Mario19831983/Volvo-DPF-indik-tor/04_bastl.jpg

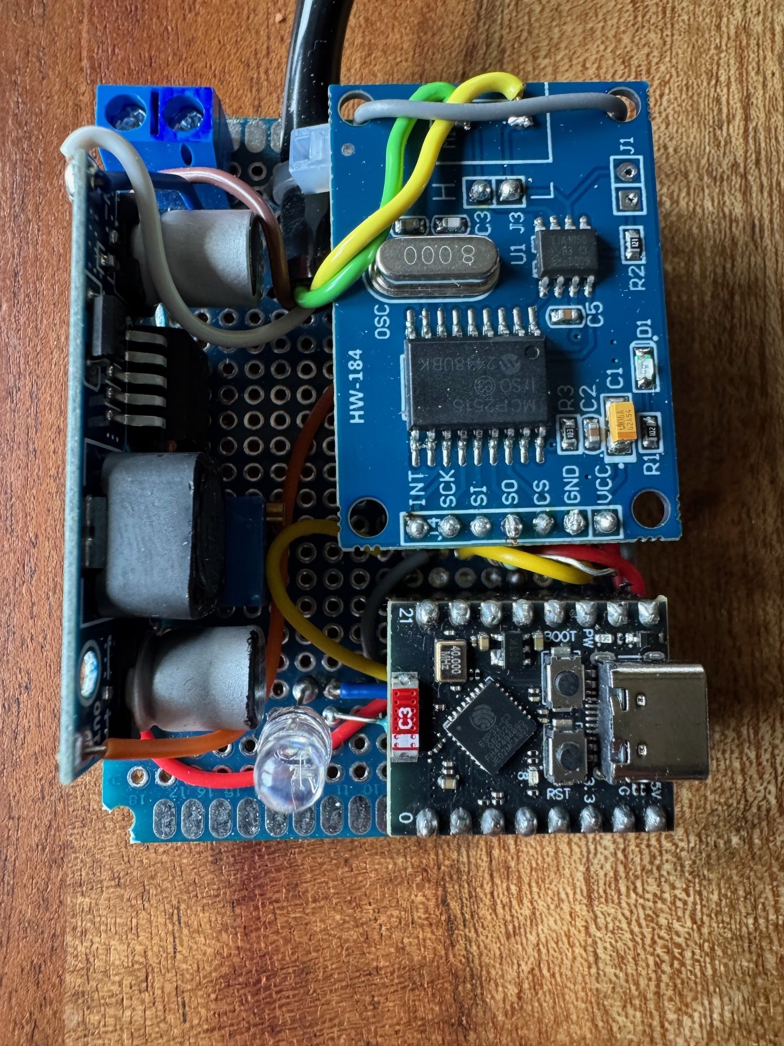
04_bastl.jpg
